LAKSHYA-2005/AI-and-IoT-Enabled-Coal-Mine-Subsidence-Monitoring-Device-SIH26025/(commit log)

2026-09-05 Refactor ADC functions and cumulative growth logic
    Updated functions to use floating-point math for ADC conversions and adjusted cumulative growth calculations to reflect net movement from baseline values.
2026-10-24 Update print statement from 'Hello' to 'Goodbye'
